eltos/sphere2-lamp/code/sphere2-lamp-ble-remote-android-app/README.md

# Sphere² Lamp - BLE Remote Android App

This Android App allows to control the lamp via Bluetooth.  
It is available on Google Play:

https://play.google.com/store/apps/details?id=com.github.eltos.sphere2lamp

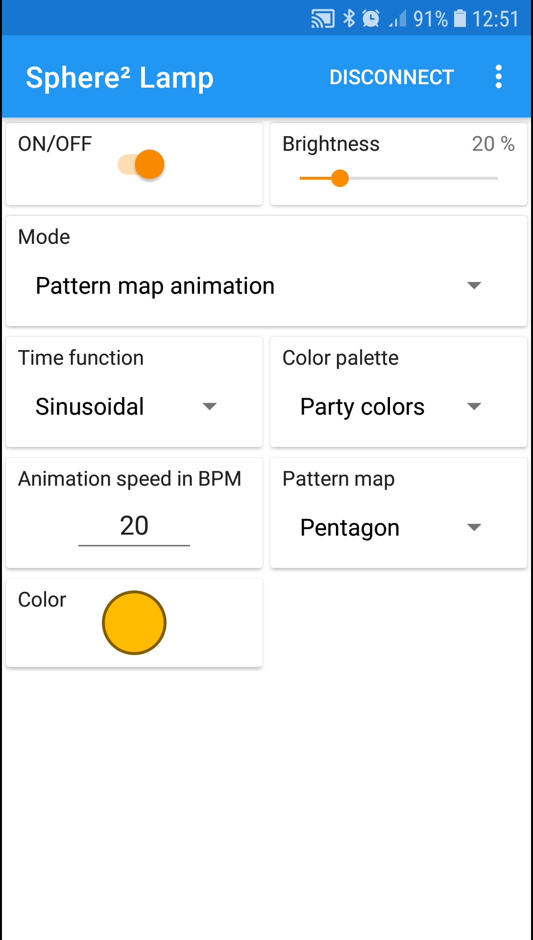
[picture p2: code/sphere2-lamp-ble-remote-android-app/store/screenshot_1.jpg]

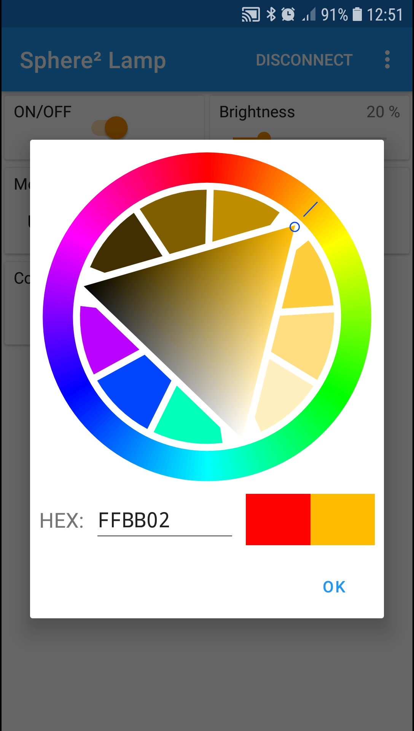
[picture p3: code/sphere2-lamp-ble-remote-android-app/store/screenshot_2.jpg]
