eltos/sphere2-lamp/code/sphere2-lamp-ble-remote-android-app/store/cover_playstore.jpg

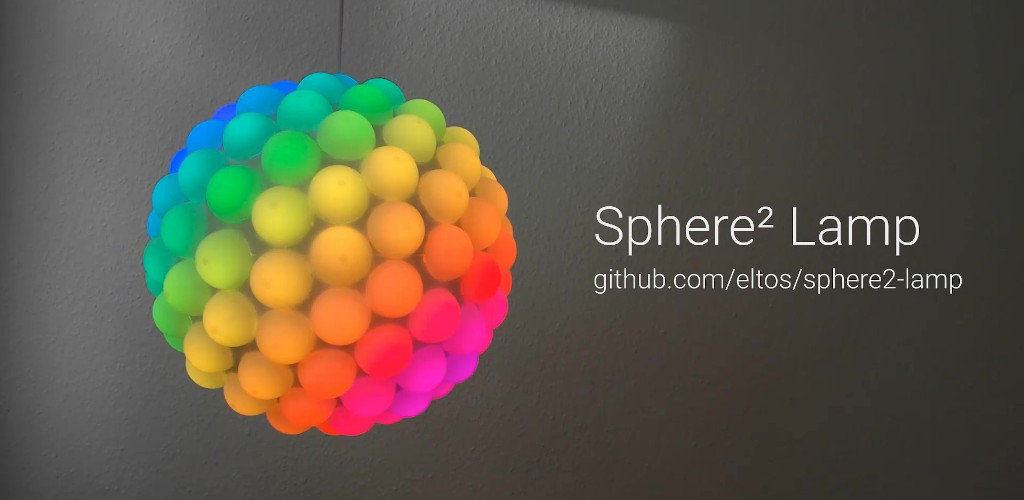
code/sphere2-lamp-ble-remote-android-app/store/cover_playstore.jpg
