eltos/sphere2-lamp/image.jpg

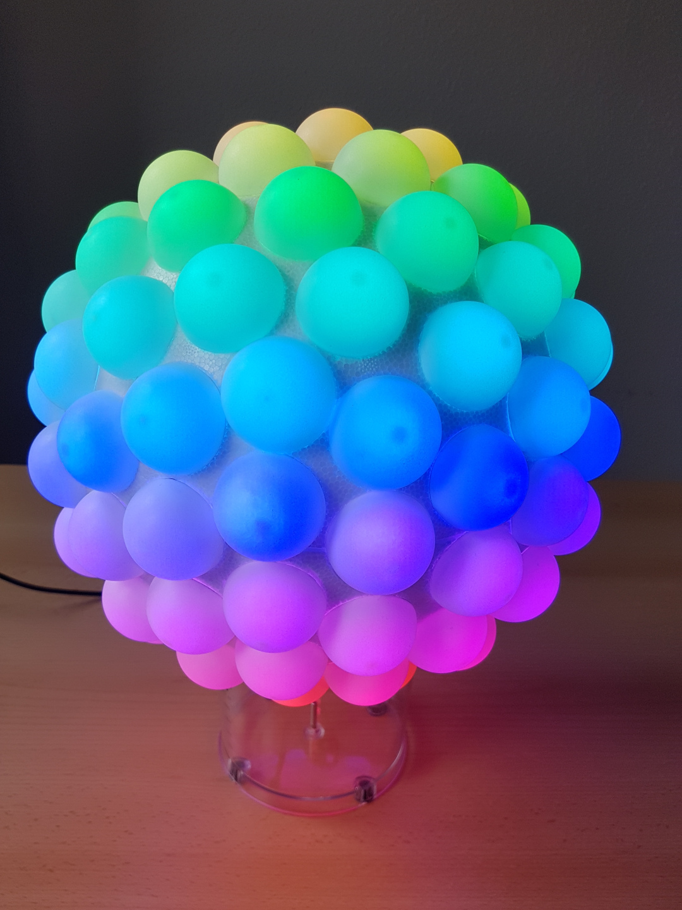
image.jpg
