eltos/sphere2-lamp/code/sphere2-lamp-python-controller/sphere2lamp.py

#!/usr/bin/env python3

# Serial driver for Sphere² Lamp
#


import serial  # pip install pyserial


# action bytes
ACTION_OFF = 0
ACTION_ON = 1
ACTION_BRIGHTNESS = 2
ACTION_DEMO = 3
ACTION_MODE = 10
ACTION_BPM = 11
ACTION_PALETTE = 12
ACTION_TIME_FUNCTION = 13
ACTION_COLOR = 14
ACTION_LED_MAP = 15
ACTION_SET_LED = 101
ACTION_SET_ALL = 102
ACTION_GET = 250

# mode bytes
MODE_MANUAL = 0
MODE_SOLID = 1
MODE_ANIM_MAP = 2
MODE_ANIM_SOLID = 3
MODE_ANIM_ROTATING_GRADIENT = 15
MODE_ANIM_POLAR_GRADIENT = 16
MODE_ANIM_AZIMUTH_GRADIENT = 17
MODE_ANIM_ROTATING_SEARCHLIGHT = 18
MODE_ANIM_ROTATING_SEARCHLIGHT_PALETTE = 19
MODE_ANIM_TWINKLE = 21
MODE_ANIM_GLITTER = 22
MODE_ANIM_SPRINKLE = 23
MODE_ANIM_SPOTLIGHTS = 24
MODE_ANIM_SPOTLIGHTS_PALETTE = 25
MODE_ANIM_POLICE = 26

# palette bytes
PALETTE_DEFAULT_RAINBOW = 0
PALETTE_RED_STRIPE = 1
PALETTE_PARTY = 2
PALETTE_OCEAN = 3
PALETTE_FOREST = 4
PALETTE_LAVA = 5
PALETTE_RGB = 6
PALETTE_SUNSET = 7
PALETTE_GRASS_GREEN = 8
PALETTE_SKY = 9
PALETTE_CRIMSON_RED = 10

# time functions
TIME_FUNCTION_SAWTOOTH = 0
TIME_FUNCTION_SAWTOOTH_REVERSE = 1
TIME_FUNCTION_TRIANGULAR = 2
TIME_FUNCTION_SINUSOIDAL = 3
TIME_FUNCTION_QUADWAVE = 4

# led maps
LED_MAP_PENTAGON = 0
LED_MAP_HEART = 1
LED_MAP_KRAKEN = 2
LED_MAP_KRAKEN_BG = 3
LED_MAP_SNAKE = 4
LED_MAP_SPIRAL = 5




class Sphere2lamp:

    def __init__(self, serial_port):
        """Serial controller for Sphere² Lamp
        :param serial_port: serial port
        """
        self.ser = serial.Serial(serial_port, timeout=5)

    def __del__(self):
        try:
            self.close()
        except:
            pass
    
    def open(self):
        """(Re-)open serial connection"""
        self.ser.open()
    
    def is_open(self):
        """Return if the serial connection is open"""
        return self.ser.is_open
    
    def close(self):
        """Close serial connection"""
        self.ser.close()
    
    def _send(self, action, *data):
        """Send action and payload
        :param action: action byte
        :param data: payload
        """
        self.ser.flushInput()
        # send single action byte
        assert self.ser.write(serial.to_bytes([action])), 'Failed to send action request'
        # wait for acknowledgement
        assert self.ser.read() == serial.to_bytes([action]), 'Action request not acknowledged'
        # send payload data
        assert self.ser.write(serial.to_bytes(data)) == len(data), 'Failed to send data'
    
    def set_on(self):
        """Turns the lamp ON
        """
        self._send(ACTION_ON)
        
    def set_off(self):
        """Turns the lamp OFF
        """
        self._send(ACTION_OFF)
    
    def get_on(self):
        """Queries if the lamp is ON
        :return: whether the lamp is on
        """
        self._send(ACTION_GET, ACTION_ON)
        return self.ser.read()[0] > 0
    
    def set_brightness(self, value):
        """Sets the overall brightness
        :param value: brightness (0..255)
        """
        self._send(ACTION_BRIGHTNESS, value)
    
    def get_brightness(self):
        """Queries the overall brightness
        :return: brightness (0..255)
        """
        self._send(ACTION_GET, ACTION_BRIGHTNESS)
        return self.ser.read()[0]
    
    def set_demo_mode(self, enabled=True):
        """En- or disables the demo mode
        :param enabled: whether the demo mode should be active
        """
        self._send(ACTION_DEMO, 1 if enabled else 0)
    
    def get_demo_mode(self):
        """Queries the demo mode enabled state
        :return: whether the demo mode is active or not
        """
        self._send(ACTION_GET, ACTION_DEMO)
        return self.ser.read()[0] > 0
    
    def set_mode(self, value):
        """Set the mode
        :param value: one of the MODE_* constants
        """
        self._send(ACTION_MODE, value)
    
    def get_mode(self):
        """Queries the mode
        :return: one of the MODE_* constants
        """
        self._send(ACTION_GET, ACTION_MODE)
        return self.ser.read()[0]
    
    def set_bpm(self, value):
        """Set the animation speed
        :param value: speed in beats per minute (0..255)
        """
        self._send(ACTION_BPM, value)
    
    def get_bpm(self):
        """Queries the animation speed
        :return: speed in beats per minute (0..255)
        """
        self._send(ACTION_GET, ACTION_BPM)
        return self.ser.read()[0]

    def set_palette(self, value):
        """Set the color palette
        :param value: one of the PALETTE_* constants
        """
        self._send(ACTION_PALETTE, value)

    def get_palette(self):
        """Queries the color palette
        :return: one of the PALETTE_* constants
        """
        self._send(ACTION_GET, ACTION_PALETTE)
        return self.ser.read()[0]
    
    def set_color_rgb(self, r, g, b):
        """Set the color as RGB
        :param r: red color component (0..255)
        :param g: green color component (0..255)
        :param b: blue color component (0..255)
        """
        self._send(ACTION_COLOR, 0, r, g, b) 
    
    def set_color_hsv(self, h, s, v):
        """Set the color as HSV
        :param h: color hue (0..255)
        :param s: color saturation (0..255)
        :param v: color value (0..255)
        """
        self._send(ACTION_COLOR, 1, h, s, v)    
    
    def get_color_rgb(self):
        """Queries the color as RGB
        :return: red color component (0..255), green color component (0..255), blue color component (0..255)
        """
        self._send(ACTION_GET, ACTION_COLOR)
        return list(self.ser.read(4))[1:]

    def set_time_function(self, value):
        """Set the time function
        :param value: one of the TIME_FUNCTION_* constants
        """
        self._send(ACTION_TIME_FUNCTION, value)

    def get_time_function(self):
        """Queries the time function
        :return: one of the TIME_FUNCTION_* constants
        """
        self._send(ACTION_GET, ACTION_TIME_FUNCTION)
        return ord(self.ser.read())

    def set_led_map(self, value):
        """Set the led map
        :param value: one of the LED_MAP_* constants
        """
        self._send(ACTION_LED_MAP, value)

    def get_led_map(self):
        """Queries the led map
        :return: one of the LED_MAP_* constants
        """
        self._send(ACTION_GET, ACTION_LED_MAP)
        return ord(self.ser.read())

    def led_rgb(self, i, r, g, b):
        """Set the color of an individual LED as RGB
        :param i: LED index, or 255 to set all at once
        :param r: red color component (0..255)
        :param g: green color component (0..255)
        :param b: blue color component (0..255)
        """
        self._send(ACTION_SET_LED, i, 0, r, g, b)

    def led_hsv(self, i, h, s, v):
        """Set the color of an individual LED as HSV
        :param i: LED index, or 255 to set all at once
        :param h: color hue (0..255)
        :param s: color saturation (0..255)
        :param v: color value (0..255)
        """
        self._send(ACTION_SET_LED, i, 1, h, s, v)

    def all_rgb(self, rgbrgbrgb):
        """Set the color of all LEDs as RGB
        :param rgbrgbrgb: LED colors as RGB (r1,g1,b1, r2,g2,b2, ...) each in range (0..255)
        """
        self._send(ACTION_SET_ALL, *rgbrgbrgb)







if __name__ == '__main__':
    import time
    
    lamp = Sphere2lamp('COM6')
    time.sleep(3)  # arduino may be reset upon connection
        
    print('Lamp is', 'ON' if lamp.get_on() else 'OFF', 'and brightness at', lamp.get_brightness())
    print('Switching on with brightness 200...')
    lamp.set_on()
    lamp.set_brightness(200)
    lamp.set_mode(MODE_ANIM_MAP)
    lamp.set_bpm(30)
    lamp.set_time_function(TIME_FUNCTION_SAWTOOTH)
    lamp.set_palette(PALETTE_DEFAULT_RAINBOW)
    lamp.set_led_map(LED_MAP_PENTAGON)
    lamp.set_color_rgb(0, 200, 0)
    
    print('Lamp is', 'ON' if lamp.get_on() else 'OFF', 'and brightness at', lamp.get_brightness())
        
    lamp.close()
