eltos/sphere2-lamp/code/sphere2-lamp/anim.ino

/**
 * Animations for the Sphere² Lamp
 * 
 */

/** 
 * Color palettes
 * (16 colors indexed as 0..255, must include both endpoints)
 * pre-defined palettes (http://fastled.io/docs/3.1/group___colorpalletes.html):
 * 
 *     RainbowColors_p          https://eltos.github.io/gradient/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
 *     OceanColors_p            https://eltos.github.io/gradient/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
 *     LavaColors_p             https://eltos.github.io/gradient/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
 *     ForestColors_p           https://eltos.github.io/gradient/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
 *     PartyColors_p            https://eltos.github.io/gradient/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
 *     RainbowStripeColors_p    
 *     CloudColors_p            
 */
CRGBPalette16 defaultPalette = RainbowColors_p;

DEFINE_GRADIENT_PALETTE( red_stripe_p ) {
    /* Edit this gradient at https://eltos.github.io/gradient/#red_stripe_p=0:000000-42.4:000000-50.3:FF0000-58.2:000000-100:000000 */
    0,   0,  0,  0,   //black
  108,   0,  0,  0,   //black
  128, 255,  0,  0,   //red
  148,   0,  0,  0,   //black
  255,   0,  0,  0};  //black

DEFINE_GRADIENT_PALETTE( sunset_p ){
    /* Edit this gradient at https://eltos.github.io/gradient/#sunset_p=0:F7E000-20:F7A100-40:F75F00-60:F71D00-100:F7E000 */
      0,  247, 224,   0,
     51,  247, 161,   0,
    102,  247,  95,   0,
    153,  247,  29,   0,
    255,  247, 224,   0};

DEFINE_GRADIENT_PALETTE( dark_ocean_p ){
    /* Edit this gradient at https://eltos.github.io/gradient/#dark_ocean_p=0965C4-0CBCC1-25A992-30649E-033076-201FAE-0965C4 */
      0,    9, 101, 196,
     42,   12, 188, 193,
     85,   37, 169, 146,
    127,   48, 100, 158,
    170,    3,  48, 118,
    212,   32,  31, 174,
    255,    9, 101, 196};

DEFINE_GRADIENT_PALETTE( grass_green_p ){
    /* Edit this gradient at https://eltos.github.io/gradient/#grass_green_p=2FAD06-07AC5C-0B973D-4B8D26-70B300-2FAD06 */
      0,   47, 173,   6,
     51,    7, 172,  92,
    102,   11, 151,  61,
    153,   75, 141,  38,
    204,  112, 179,   0,
    255,   47, 173,   6};

DEFINE_GRADIENT_PALETTE( crimson_red_p ){
    /* Edit this gradient at https://eltos.github.io/gradient/#crimson_red_p=830900-740700-6F001E-6B0040-570755-830900 */
      0,  131,   9,   0,
     51,  116,   7,   0,
    102,  111,   0,  30,
    153,  107,   0,  64,
    204,   87,   7,  85,
    255,  131,   9,   0};

DEFINE_GRADIENT_PALETTE( rgb_p ) {
  /* Edit this gradient at https://eltos.github.io/gradient/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 */
      0,  255,   0,   0,
     42,  255,   0,   0,
     85,    0, 255,   0,
    127,    0, 255,   0,
    170,    0,   0, 255,
    212,    0,   0, 255,
    255,  255,   0,   0};



/**
 * Function macros producing continuous linear/triangular/sinusoidal/quadratric sweeps with given BPM
 */
#define SAWTOOTH [](accum88 bpm){return beat8(bpm);}               // sawtooth
#define SAWTOOTH_REVERSE [](accum88 bpm){return (uint8_t)(255-beat8(bpm));}   // reverse sawtooth
#define TRIANGULAR [](accum88 bpm){return triwave8(beat8(bpm));}   // triangular
#define SINUSOIDAL [](accum88 bpm){return beatsin8(bpm);}          // sinusoidal
#define QUADWAVE [](accum88 bpm){return quadwave8(beat8(bpm));}    // quadratic sinusoidal (spends just a little more time at the limits)

/**
 * Gradient function producing flashes for a linear input
 * 
 * @param x: input parameter linear in range 0 to 255
 * @param flashes: number of flashes
 * @return: function output in range 0 to 255
 */
uint8_t flash(uint8_t x, uint8_t flashes = 1, uint8_t min = 0, uint8_t max = 255){
  float s = pow(255-x, 2)/255;
  uint8_t v = s*pow(cos(PI*flashes*s/255), 2);
  return min + scale8(v, max-min);
}

/**
 * A version of the flash function with slightly longer initial light up
 * 
 * @param x: input parameter linear in range 0 to 255
 * @param flashes: number of flashes
 * @return: function output in range 0 to 255
 */
uint8_t blink(uint8_t x, uint8_t flashes = 1, uint8_t min = 0, uint8_t max = 255){
  float s = pow(255-x, 2)/255;
  uint8_t v = s*pow(cos(PI*(flashes+0.25)*s/255), 2);
  return min + scale8(v, max-min);
}




/********************************
 * Texture map based animations *
 ********************************/


/**
 * Predefined maps mapping the LED number (index) to a certain color/hue.
 */
const uint8_t MAP_PENTAGON[NUM_LEDS] PROGMEM = {0,1,1,1,1,1,2,2,2,2,2,2,2,2,2,2,1,2,1,0,1,2,1,0,1,2,1,0,1,2,1,0,1,2,1,0,1,2,1,1,1,2,1,1,1,2,1,1,1,2,1,1,1,2,1,1,2,2,2,2,2,2,2,2,2,2,2,1,1,1,2,1,1,1,2,1,1,1,2,1,1,1,2,1,1,1,2,1,0,1,2,1,0,1,2,1,0,1,2,1,0,1,2,1,0,1,2,2,2,2,2,2,2,2,2,2,1,1,1,1,1,0};
const uint8_t MAP_HEART[NUM_LEDS] PROGMEM = {0,0,0,0,0,0,0,0,0,0,0,0,0,0,0,0,1,1,1,1,0,0,0,0,0,0,0,0,0,0,0,0,0,0,0,1,0,0,0,1,0,0,0,0,0,0,0,0,0,0,0,0,0,0,0,1,1,1,0,0,0,0,0,0,0,0,0,0,1,0,0,0,0,0,0,0,0,0,0,0,0,0,0,0,0,0,0,0,0,0,0,0,0,0,0,0,0,0,0,0,0,0,0,0,0,0,0,0,0,0,0,0,0,0,0,0,0,0,0,0,0,0};
const uint8_t MAP_KRAKEN[NUM_LEDS] PROGMEM = {1,2,2,2,2,2,3,16,3,16,3,16,3,16,3,16,0,4,0,15,0,4,0,15,0,4,0,15,0,4,0,15,0,4,0,15,0,5,0,14,0,5,0,14,0,5,0,14,0,5,0,14,0,5,0,14,0,0,0,0,0,0,0,0,0,0,13,0,6,0,13,0,6,0,13,0,6,0,13,0,6,0,13,0,6,0,12,0,7,0,12,0,7,0,12,0,7,0,12,0,7,0,12,0,7,0,11,8,11,8,11,8,11,8,11,8,10,10,10,10,10,9};
const uint8_t MAP_SNAKE[NUM_LEDS] PROGMEM = {0,0,0,0,0,0,0,0,0,0,0,0,0,0,0,0,13,0,4,0,3,0,44,0,43,0,34,0,33,0,24,0,23,0,14,0,12,0,5,0,2,0,45,0,42,0,35,0,32,0,25,0,22,0,15,0,11,6,1,46,41,36,31,26,21,16,0,10,0,7,0,50,0,47,0,40,0,37,0,30,0,27,0,20,0,17,0,9,0,8,0,49,0,48,0,39,0,38,0,29,0,28,0,19,0,18,0,0,0,0,0,0,0,0,0,0,0,0,0,0,0,0};
const uint8_t MAP_SPIRAL[NUM_LEDS] PROGMEM = {1,2,2,2,2,2,3,0,3,0,3,0,3,0,3,0,4,0,0,5,4,0,0,5,4,0,0,5,4,0,0,5,4,0,0,5,0,7,6,0,0,7,6,0,0,7,6,0,0,7,6,0,0,7,6,0,8,0,8,0,8,0,8,0,8,0,9,0,0,10,9,0,0,10,9,0,0,10,9,0,0,10,9,0,0,10,0,12,11,0,0,12,11,0,0,12,11,0,0,12,11,0,0,12,11,0,13,0,13,0,13,0,13,0,13,0,14,14,14,14,14,15};
const uint8_t MAP_EARTH[NUM_LEDS] PROGMEM = {2,2,2,2,2,2,1,2,2,2,3,1,4,4,1,1,1,1,3,3,3,3,3,4,3,4,1,1,1,1,4,4,3,1,1,1,1,1,1,3,3,1,4,4,4,4,4,1,1,3,3,1,1,1,1,1,1,3,1,1,3,1,3,1,1,1,1,1,3,4,1,1,1,1,3,3,1,1,3,3,3,1,1,1,1,1,1,1,4,4,4,1,1,1,3,1,1,1,1,3,3,1,1,1,1,1,1,1,1,1,1,1,1,1,1,1,2,2,2,2,2,2};

/**
 * Predefined texture colors defining the colors
 */
const CRGB MAP_EARTH_COLORS[5] = {CRGB(0,0,0), CRGB(0,0,200), CRGB(255,255,255), CRGB(0,200,0), CRGB(100,150,0)};
const CRGB MAP_RGB_COLORS[3] = {CRGB::Red, CRGB::Green, CRGB::Blue};

/**
 * Build a map with equally distributed hues (linear gradient) as required for the given LED map
 * Make sure to free the hue_map after usage using: free(hue_map);
 * 
 * @param led_map: array mapping LED indices to color indices
 * @param skip_zero: if true, the value 0 in led_map is assigned hue 0
 * @param hue_start: first hue of linear gradient (inclusive)
 * @param hue_stop: last hue of linear gradient (exclusive)
 */
uint8_t* build_hue_map(uint8_t* led_map, bool skip_zero = false, uint8_t hue_start = 0, uint8_t hue_stop = 255){
  // count required hues
  uint8_t num_hues = 0;
  for (size_t i = 0; i < NUM_LEDS; ++i){
    if (led_map[i] > num_hues) num_hues = led_map[i];
  }
  num_hues++;
  // create equally distributed hue map
  uint8_t *hue_map = (uint8_t *) malloc(num_hues*sizeof(uint8_t));
  if (hue_map == NULL){ return NULL; } // out of RAM
  if (skip_zero){
    hue_map[0] = 0;
    num_hues--;
  }
  for (size_t i = 0; i < num_hues; ++i){
    hue_map[skip_zero ? i+1 : i] = hue_start + (hue_stop - hue_start)*i/num_hues;
  }
  return hue_map;
}


/**
 * Set LED colors based on a texture map
 * 
 * @param led_map: array mapping LED indices to color indices
 * @param map_colors: array with colors
 */
void fill_map(uint8_t* led_map = MAP_PENTAGON, CRGB* map_colors = MAP_RGB_COLORS){
  for (size_t i = 0; i < NUM_LEDS; ++i){
    leds[i] = map_colors[led_map[i]];
  }
}

/**
 * Set LED colors for a part of a texture map
 * 
 * @param led_map: array mapping LED indices to color indices
 * @param number: number in map to consider
 * @param color: color to set
 */
void fill_submap(uint8_t* led_map, size_t number, CRGB color){
  for (size_t i = 0; i < NUM_LEDS; ++i){
    if (led_map[i] != number){ continue; }
    leds[i] = color;
  }
}

/**
 * Animate LED color based on a texture map and (initial) hue
 * 
 * @param led_map: array mapping LED indices to color hue index
 * @param map_hues: array with hues to start with for each index
 * @param bpm: hue shift animation speed in cycles (beats) per minute
 * @param palette: color palette to map distances to color
 * @param function8: function to calculate color palette hue shift as function of bpm and time
 * @param brightness: LED brightness
 * @param blending: blending type for color palette
 * @param zero_is_off: if true, the value 0 in led_map has the special meaning of zero brightness
 */
template <typename F = uint8_t(accum88)>
void anim_map(uint8_t* led_map, uint8_t* map_hues, uint8_t bpm = 10, CRGBPalette16* palette = &defaultPalette,
              F function8 = SAWTOOTH, uint8_t brightness = 255, TBlendType blending = LINEARBLEND, bool zero_is_off = false){
  for (size_t i = 0; i < NUM_LEDS; ++i){
    uint8_t hue = function8(bpm) - map_hues[led_map[i]];
    leds[i] = ColorFromPalette(*palette, hue, zero_is_off && led_map[i] == 0 ? 0 : brightness, blending);
  }
}

/**
 * Shortcut for anim_map(led_map, map_hues, ...) dynamically using equally distributed hues
 */
template <typename F = uint8_t(accum88)>
void anim_map(uint8_t* led_map = MAP_PENTAGON, uint8_t bpm = 10, CRGBPalette16* palette = &defaultPalette,
              F function8 = SAWTOOTH, uint8_t brightness = 255, TBlendType blending = LINEARBLEND, bool zero_is_off = false){
  uint8_t *hue_map = build_hue_map(led_map, zero_is_off);
  anim_map(led_map, hue_map, bpm, palette, function8, brightness, blending, zero_is_off);
  free(hue_map);
}

/**
 * Animate LED color based on a part of a texture map
 * 
 * @param led_map: array mapping LED indices to color hue index
 * @param number: number in map to consider
 * @param bpm: hue shift animation speed in cycles (beats) per minute
 * @param palette: color palette to map distances to color
 * @param function8: function to calculate color palette hue shift as function of bpm and time
 * @param brightness: LED brightness
 * @param blending: blending type for color palette
 */
template <typename F = uint8_t(accum88)>
void anim_submap(uint8_t* led_map, size_t number, uint8_t bpm = 10, CRGBPalette16* palette = &defaultPalette,
              F function8 = SAWTOOTH, uint8_t brightness = 255, TBlendType blending = LINEARBLEND, bool zero_is_off = false){
  for (size_t i = 0; i < NUM_LEDS; ++i){
    if (led_map[i] != number) continue;
    uint8_t hue = function8(bpm);
    leds[i] = ColorFromPalette(*palette, hue, brightness, blending);
  }
}


/**
 * Animate solid LED color
 * 
 * @param bpm: hue shift animation speed in cycles (beats) per minute
 * @param palette: color palette to map distances to color
 * @param function8: function to calculate color palette hue shift as function of bpm and time
 * @param brightness: LED brightness
 * @param blending: blending type for color palette
 */
template <typename F = uint8_t(accum88)>
void anim_solid(uint8_t bpm = 10, CRGBPalette16* palette = &defaultPalette, F function8 = SAWTOOTH,
                uint8_t brightness = 255, TBlendType blending = LINEARBLEND){
  uint8_t hue = function8(bpm);
  CRGB color = ColorFromPalette(*palette, hue, brightness, blending);
  fill_solid(leds, NUM_LEDS, color);
}




/***************************************
 * Position and angle based animations *
 ***************************************/


/**
 * Animate LEDs based on their distance to a given spherical coordinate
 * 
 * @param theta: polar angle of reference point in range 0 (north pole) to 255 (south pole)
 * @param phi: azimuthal angle of reference point in range 0 to 255
 * @param bpm: hue shift animation speed in cycles (beats) per minute
 * @param palette: color palette to map distances to color
 * @param function8: function to calculate color palette hue shift as function of bpm and time
 * @param brightness: LED brightness
 * @param blending: blending type for color palette
 */
template <typename F = uint8_t(accum88)>
void anim_distance(uint8_t theta, uint8_t phi, uint8_t bpm = 10, CRGBPalette16* palette = &defaultPalette,
                   F function8 = SAWTOOTH, uint8_t brightness = 255, TBlendType blending = LINEARBLEND){
  for (size_t i = 0; i < NUM_LEDS; ++i){
    uint8_t hue = distance(THETA[i], PHI[i], theta, phi) + function8(bpm);
    leds[i] = ColorFromPalette(*palette, hue, brightness, blending);
  }
}

template <typename F = uint8_t(accum88)>
void anim_distance_led(size_t led, uint8_t bpm = 10, CRGBPalette16* palette = &defaultPalette,
                       F function8 = SAWTOOTH, uint8_t brightness = 255, TBlendType blending = LINEARBLEND){
  anim_distance(THETA[led], PHI[led], bpm, palette, function8, brightness, blending);
}

/**
 * Animate LEDs based on the azimuthal angle
 * 
 * @param bpm: hue shift animation speed in cycles (beats) per minute
 * @param palette: color palette to map angle to color
 * @param tip_color: color of tips with undefined azimuthal angle
 * @param function8: function to calculate color palette hue shift as function of bpm and time
 * @param brightness: LED brightness
 * @param blending: blending type for color palette
 */
template <typename F = uint8_t(accum88)>
void anim_azimuth(uint8_t bpm = 10, CRGBPalette16* palette = &defaultPalette, CRGB tip_color = CRGB::White,
                  F function8 = SAWTOOTH, uint8_t brightness = 255, TBlendType blending = LINEARBLEND){
  leds[0] = tip_color;
  leds[NUM_LEDS-1] = tip_color;
  for (size_t i = 1; i < NUM_LEDS-1; ++i){
    leds[i] = ColorFromPalette(*palette, PHI[i] + function8(bpm), brightness, blending);
  }
}



/*******************************
 * Various animation functions *
 *******************************/


/*
 * Animation counting the LEDS in their internal wireing order 
 * for testing and debugging purposes
 * 
 * @param brightness: maximum LED brightness
 */
void anim_count(uint8_t brightness = 255){
  uint8_t c = beat8(1);
  if (c == 0){
    FastLED.clear();
  } else if (c <= NUM_LEDS){
    uint8_t hue = 255 * ((c-1)%12) / 12;
    leds[c-1] = ColorFromPalette(defaultPalette, hue, brightness, LINEARBLEND);
  }
}

/**
 * Twinkling animation of the full sphere creating a shimmering effect
 * 
 * Every LED cycles through the given color palette using a sinusoidal function 
 * with a random initial phase and slightly different BPMs. The brightniss as a 
 * whole is modulated with twice the given BPM by -20% if enabled.
 * 
 * @param bpm: animation speed in cycles (beats) per minute (actual value is up to 5 larger for some LEDs)
 * @param palette: color palette to use
 * @param brightness: maximum LED brightness
 * @param modulate_brightness: if true, modulate brightness, i.e. dim by 20%
 */
 void anim_twinkle(uint8_t bpm = 3, CRGBPalette16* palette = &defaultPalette, 
                   uint8_t brightness = 255, bool modulate_brightness = true){
  for (size_t i = 0; i < NUM_LEDS; ++i){
    uint8_t hue = beatsin8(bpm+i%5, 0, 255, 0, inoise8(THETA[i]<<5, PHI[i]<<5)); // noisy phase in 24..240
    uint8_t bright = !modulate_brightness ? brightness : beatsin8(2*bpm+1, scale8(brightness, 200), brightness); //, 0, inoise8(PHI[i]<<5, THETA[i]<<5));
    leds[i] = ColorFromPalette(*palette, hue, bright, LINEARBLEND);
  }
}

/**
 * Sprinkling animation with random LEDs lighting up and fading with random color
 * 
 * Every LED cycles through the given color palette using a sinusoidal function 
 * with a random initial phase and slightly different BPMs. The brightniss as a 
 * whole is modulated with twice the given BPM by -20% if enabled.
 * 
 * @param bpm: animation speed in cycles per minute
 * @param palette: color palette to use
 * @param n: number of spinkles per cycle
 * @param brightness: LED brightness
 * @param blending: blending type for color palette
 */
void anim_sprinkle(uint8_t bpm = 30, CRGBPalette16* palette = &defaultPalette, uint8_t n = 100,
                   uint8_t brightness = 255, TBlendType blending = LINEARBLEND){
  EVERY_N_MILLISECONDS(10){
    fadeToBlackBy(leds, NUM_LEDS, 5);
  }
  EVERY_N_MILLIS_I(variableTimer, 0) {
    int pos = random16(NUM_LEDS);
    leds[pos] += ColorFromPalette(*palette, random8(), brightness, blending);
  }
  variableTimer.setPeriod(60000/n/bpm);
}


/**
 * Make an led switch between two colors to visualize the fps
 * 
 * @param led: the LED number, or all if greater than NUM_LEDS
 * @param color1: the first color
 * @param color2: the second color
 */
void anim_fps(size_t led = 0, CRGB color1 = CRGB::Red, CRGB color2 = CRGB::Blue){
  static bool tick = true;
  if (led >= 0 && led < NUM_LEDS){
    leds[led] = tick ? color1 : color2;
  } else {
    fill_solid(leds, NUM_LEDS, tick ? color1 : color2);
  }
  tick = !tick;
}



/**
 * Create a rotating searchlight/radar, lighting up and fading the LEDs according to their azimuthal angle phi
 * 
 * @param color: color of searchlight
 * @param bpm: turns per minute
 * @param tail: length of fading-out tail from 0..255
 * @param head: length of fading-in head from 0..255
 * @param ping_led: LED to flash at maximum brightness when hit by the searchlight/radar
 * @param ping_hue: color hue of flash
 * @param blend_over: if true, blends the animation over the existing colors instead of overwriting them
 */
void anim_searchlight(CRGB color, uint8_t bpm = 20, uint8_t tail = 100, uint8_t head = 20, uint8_t phase = 0,
                      size_t ping_led = -1, uint8_t ping_hue = 0, bool blend_over = false){
  if (!blend_over) FastLED.clear();
  for (size_t i = 0; i < NUM_LEDS; ++i){
    uint8_t pos = SAWTOOTH(bpm) - PHI[i] + phase;
    if (i == ping_led){
      pos = 255-pos;
      color = CHSV(ping_hue, 255, pos);
    } else {
      if (i == 0 || i == NUM_LEDS-1){
        pos = 255;
      } else if (pos < head){
        pos = 255.0*pos/head;
      } else if (pos < head + tail){
        pos = 255*(1-(pos-head)*1.0/tail);
      } else {
        pos = 0;
      }
    }
    leds[i] = nblend(leds[i], color, pos);
  }
}

/**
 * Variant of anim_searchlight with the color transitioning according to a palette
 * 
 * @param palette: color palette of searchlight
 * @param palette_bpm: color palette cycle speed
 * @param function8: function to calculate color palette hue shift as function of bpm and time
 * @param bpm: turns per minute
 * @param tail: length of fading-out tail from 0..255
 * @param head: length of fading-in head from 0..255
 * @param ping_led: LED to flash at maximum brightness when hit by the searchlight/radar
 * @param ping_hue: color hue of flash
 * @param blend_over: if true, blends the animation over the existing colors instead of overwriting them
 * @param brightness: LED palette brightness
 * @param blending: blending type for color palette
 */
template <typename F = uint8_t(accum88)>
void anim_searchlight(CRGBPalette16* palette = &defaultPalette, uint8_t palette_bpm = 3, F function8 = SAWTOOTH,
                      uint8_t bpm = 20, uint8_t tail = 100, uint8_t head = 20, uint8_t phase = 0,
                      size_t ping_led = -1, uint8_t ping_hue = 0, bool blend_over = false,
                      uint8_t brightness = 255, TBlendType blending = LINEARBLEND){
  CRGB color = ColorFromPalette(*palette, function8(palette_bpm), brightness, blending);
  anim_searchlight(color, bpm, tail, head, phase, ping_led, ping_hue, blend_over);
}




/**
 * Make a red/blue flashing revolving alarm light
 * 
 * @param bpm: animation speed in cycles per minute
 */
void anim_police_lights(uint8_t bpm = 60){
  FastLED.clear();
  anim_searchlight(CHSV(HUE_RED,  255, flash(beat8(2*bpm)    , 3, 80)), bpm, 100, 20,   0, -1, 0, true);
  anim_searchlight(CHSV(HUE_BLUE, 255, flash(beat8(2*bpm)+128, 3, 80)), bpm, 100, 20, 128, -1, 0, true);
  leds[0] = CRGB::White;
  leds[NUM_LEDS-1] = CRGB::White;
}





/**
 * Lava-lamp like animation with blobs moving from bottom to top and back
 * 
 * @param color: color of bulbs
 * @param bpm: animation speed in cycles per minute
 * @param size: blob size
 */
template <size_t BLOBS = 3>
void anim_add_lava_blobs(CRGB color = CRGB::Red, uint8_t bpm = 2, uint8_t size = 50){
  static uint8_t blob_theta[BLOBS] = {0};
  static uint8_t blob_phi[BLOBS] = {0};
  EVERY_N_MILLISECONDS(25) {
    // bulbs
    for (size_t b = 0; b < BLOBS; ++b){
      // make bulb rise and fall
      uint8_t theta = beatsin8(bpm, 0, 255, 0, b*255/BLOBS); // quadwave8(
      // on change of direction (at top/bottom) change azimuthal angle
      if (theta != blob_theta[b] && (theta > blob_theta[b]) == blob_phi[b]%2){
        blob_phi[b] = blob_phi[b] + 1 + 2*random8();
      }
      blob_theta[b] = theta;
      // draw
      uint8_t radius = size + scale8(beatsin8(10*bpm), 7);
      for (size_t i = 0; i < NUM_LEDS; ++i){
        if (absdiff8(THETA[i], blob_theta[b]) > radius) continue; // d > radius anyways, skip for speed improvement
        uint8_t d = distance(THETA[i], PHI[i], blob_theta[b], blob_phi[b]);
        if (d < radius){
          d = 255-255*d/radius;
          leds[i] = nblend(leds[i], color, d);
        }
      }
    }
  }
}  


/**
 * Make some LEDs flash randomly.
 * The default parameters create a "thunderstorm with lightning on the globe" like animation.
 * 
 * @tparam FLASHLIGHTS: count of flashing LEDs
 * @param color: color of flash animation
 * @param flashing: number of light-dark cycles per flash animation
 * @param duration: duration of flash animation in ms (minimum 25)
 * @param delay: mean delay between animations in ms (everything < 25ms is equal to zero)
 */
template <size_t FLASHLIGHTS = 5>
void anim_add_flashes(CRGB color = CRGB::White, uint8_t flashing = 2, uint16_t duration = 400, uint16_t delay = 500){
  static size_t flash_led[FLASHLIGHTS] = {0};       // LED numbers
  static uint8_t flash_bright[FLASHLIGHTS] = {0};   // current blending brightness
  static uint8_t flash_counter[FLASHLIGHTS] = {0};  // animation frame counter from 255..0
  // calculate flash animation at 40 fps
  EVERY_N_MILLISECONDS(25) {
    for (size_t i = 0; i < FLASHLIGHTS; ++i){
      if (flash_counter[i] < 6375/duration){
        // animation ended
        flash_counter[i] = 0;
        flash_bright[i] = 0;
        // create new spot with probatibility p
        if (!delay || random8() < 6375/delay){ // random8 < 255*p where p = 25/FLASHDELAY
          flash_led[i] = random8(NUM_LEDS);
          flash_counter[i] = 255;
          if (delay && delay <= 25 && random8() < 128){
            flash_counter[i] -= 6375/duration; // make animations diverge even if they start immediately
          }
        }
      } else {
        // animate flash
        flash_counter[i] -= 6375/duration; // counter from 255 to 0      
        flash_bright[i] = flash(flash_counter[i], flashing);
      }
    }
  }
  // overlay flashs (current animation frame) with leds
  for (size_t i = 0; i < FLASHLIGHTS; ++i){
    nblend(leds[flash_led[i]], color, flash_bright[i]);
    //anim_distance(THETA[i], PHI[i], 235/50*DIMMING, &red_stripe, QUADWAVE); // BPM = 235/EVERY_MS*DIMMING
  }
}
