eltos/sphere2-lamp/(commit log)

2021-06-14 Add button for transparency
2021-06-30 Adjustable LED map
2021-07-02 Allow to filter items based on mode
2021-07-04 Interactive 3D model to control LEDs over USB
2021-07-14 Improve bluetooth connect flow
2021-08-06 Fix variable timer period
    [anim.ino]
2021-11-28 Keep main thread alive
2022-05-07 Add links to Hackster, Arduino HUB, Arduino Blog
2022-09-03 Highlight and auto-select Sphere² Lamp in BLE device list
